eaterofnames/openoffroad/README.md

# openoffroad

A collection of offroad related part designs.

## Included parts:

* Rivian
    * R1T
        * Apex Designs Compact Reel System mount
        * Garmin PowerSwitch mount
