eaterofnames/openoffroad/rivian/common/garmin-powerswitch-mount/GarminPowerswitchLightBracket.dxf

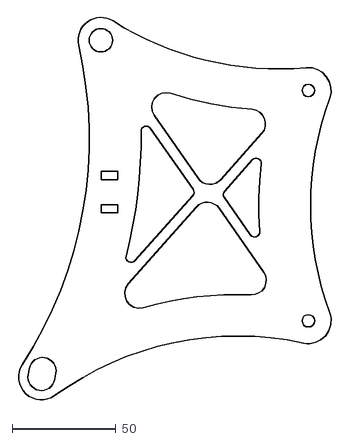
[picture p3: CAD file, 2024-07-14]
rivian/common/garmin-powerswitch-mount/GarminPowerswitchLightBracket.dxf
152.6 x 186.2
