eaterofnames/openoffroad/rivian/r1t/apex-air-reel-mount/FlatPatternOfAirReelBracket.dxf

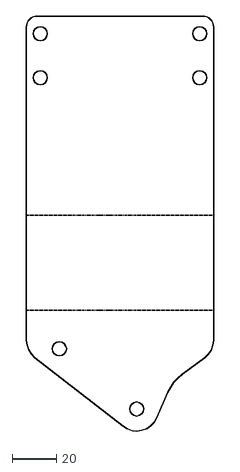
[picture p4: CAD file, 2024-07-14]
rivian/r1t/apex-air-reel-mount/FlatPatternOfAirReelBracket.dxf
85.0 x 189.0
