eaterofnames/openoffroad/rivian/r1t/apex-air-reel-mount/AirReelBracket.step

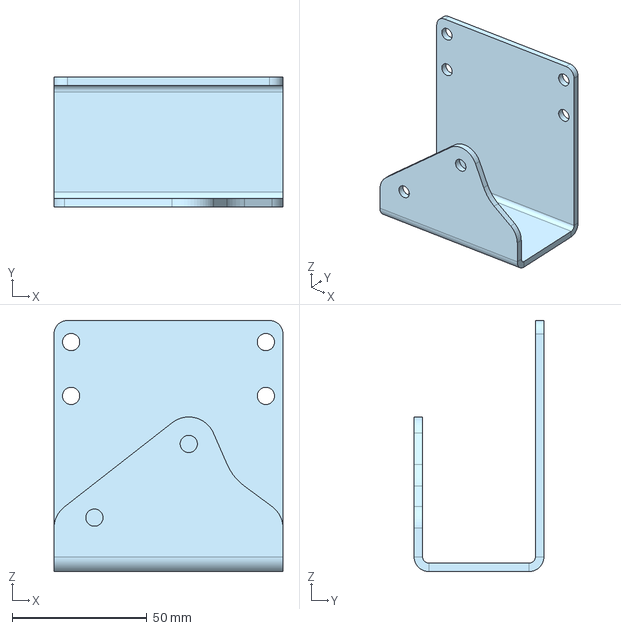
[picture p5: CAD file, 2024-07-14]
rivian/r1t/apex-air-reel-mount/AirReelBracket.step
85.0 x 48.2 x 93.2 mm
