eaterofnames/openoffroad/rivian/r1t/apex-air-reel-mount/GearGuardInsert.step

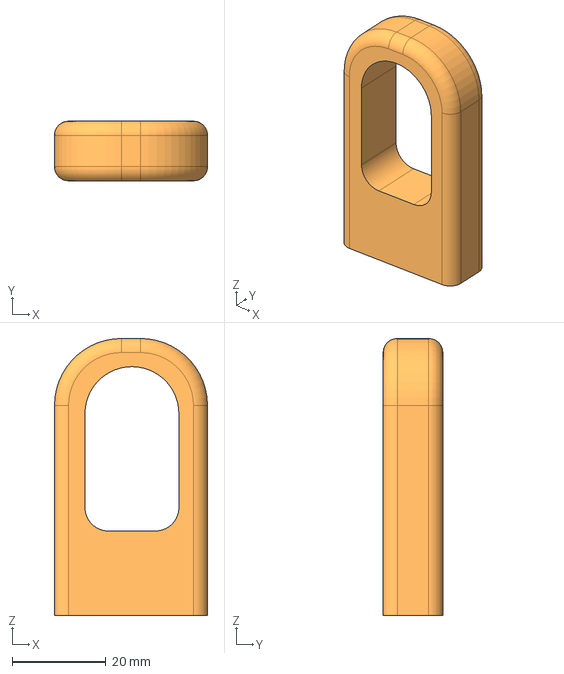
[picture p6: CAD file, 2024-07-14]
rivian/r1t/apex-air-reel-mount/GearGuardInsert.step
32.6 x 12.7 x 59.0 mm
