eaterofnames/openoffroad/rivian/r1t/apex-air-reel-mount/GearGuardInsertDrawing.pdf

2
1

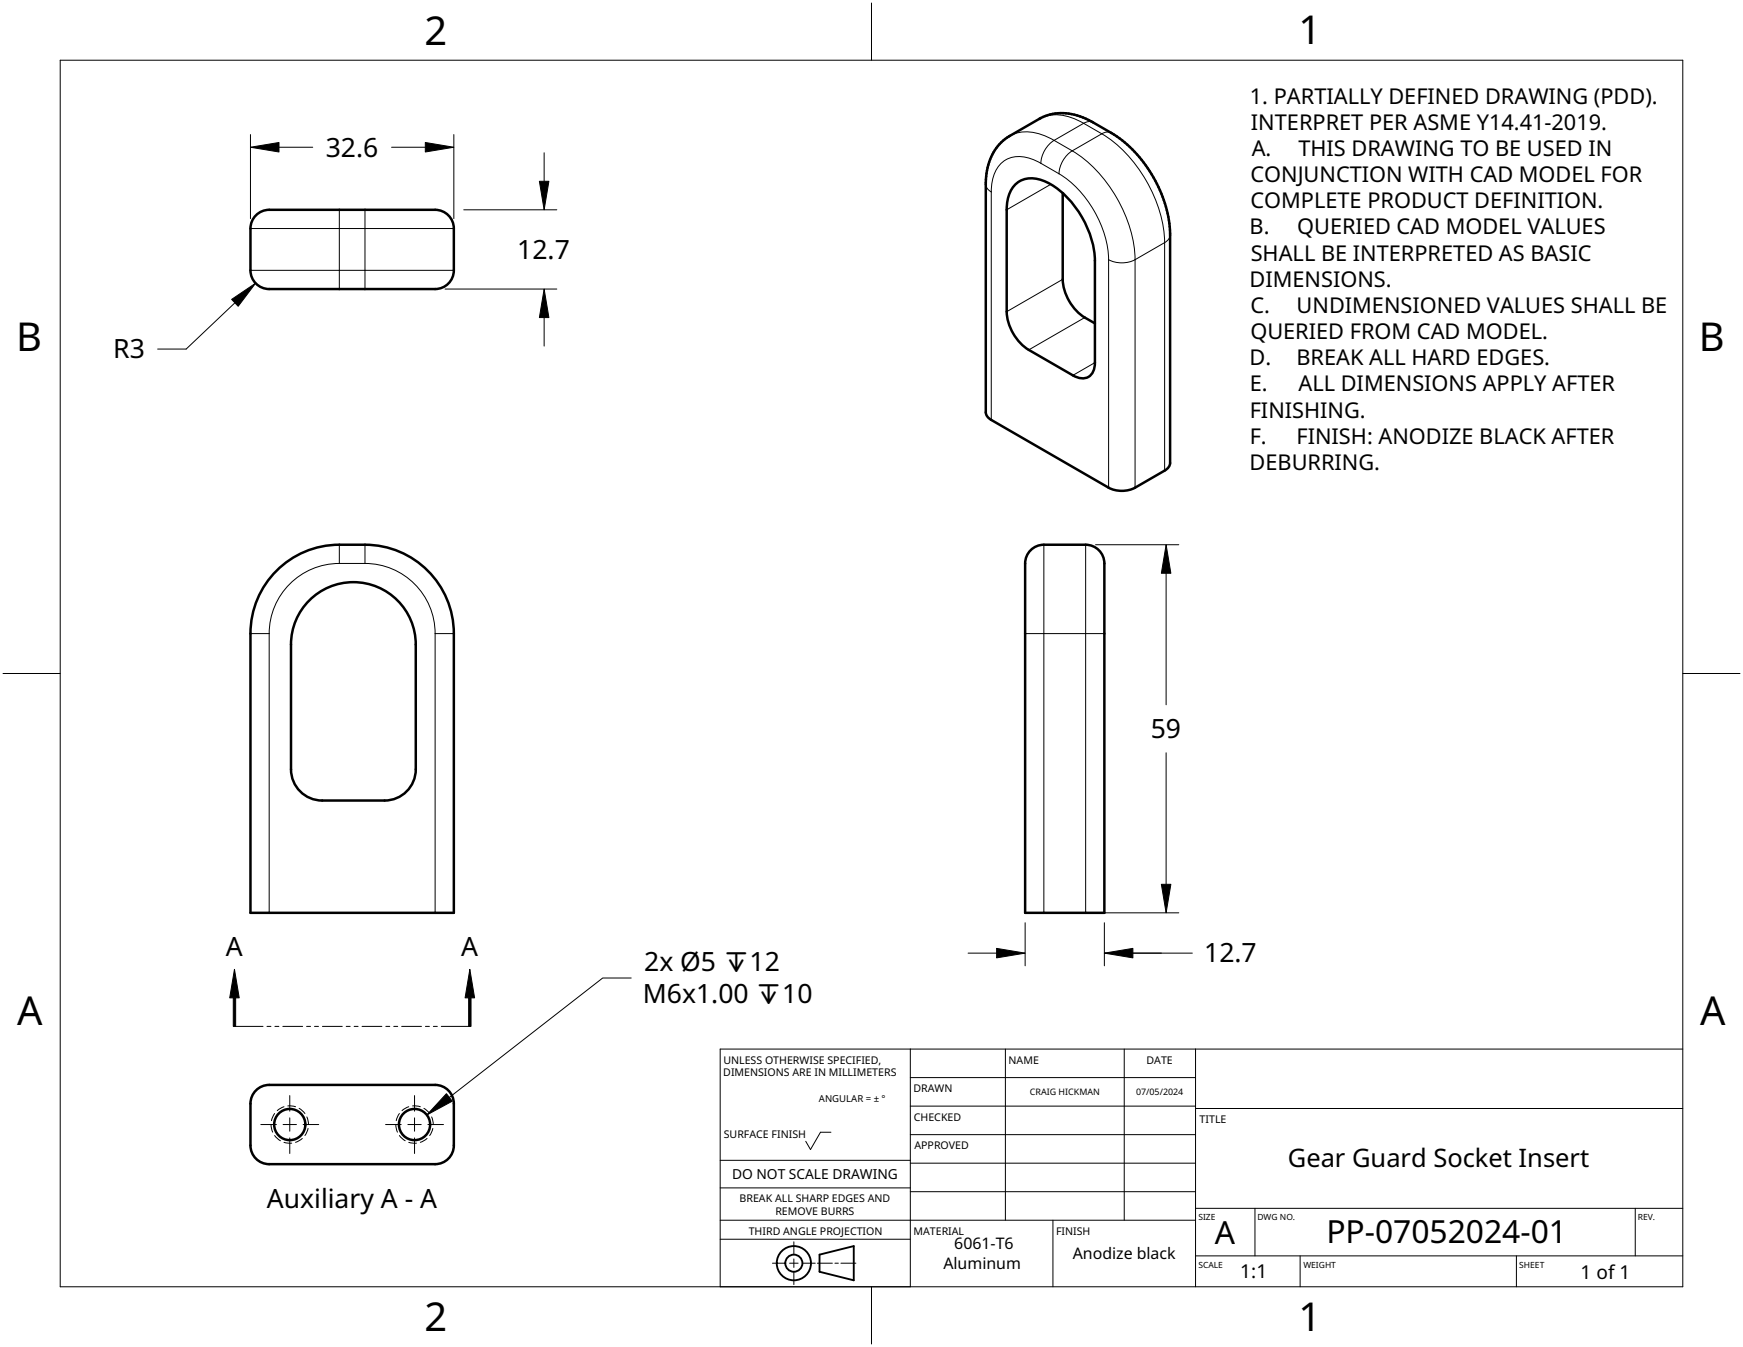
[picture p7: page 1]
MATERIAL 6061-T6 Aluminum; FINISH Anodize black; Auxiliary A - A

1. PARTIALLY DEFINED DRAWING (PDD).
INTERPRET PER ASME Y14.41-2019.
A. THIS DRAWING TO BE USED IN
CONJUNCTION WITH CAD MODEL FOR
COMPLETE PRODUCT DEFINITION.
B. QUERIED CAD MODEL VALUES
SHALL BE INTERPRETED AS BASIC
DIMENSIONS.
C. UNDIMENSIONED VALUES SHALL BE
QUERIED FROM CAD MODEL.
D. BREAK ALL HARD EDGES.
E. ALL DIMENSIONS APPLY AFTER
FINISHING.
F. FINISH: ANODIZE BLACK AFTER
DEBURRING.

UNLESS OTHERWISE SPECIFIED, DIMENSIONS ARE IN MILLIMETERS ANGULAR = ± ° SURFACE FINISH | | NAME | DATE

DRAWN | CRAIG HICKMAN | 07/05/2024

CHECKED | | | TITLE Gear Guard Socket Insert

APPROVED

DO NOT SCALE DRAWING

BREAK ALL SHARP EDGES AND

REMOVE BURRS
THIRD ANGLE PROJECTION

SIZE A | DWG NO. PP-07052024-01 | REV.

SCALE 1:1 | WEIGHT | SHEET 1 of 1
