eaterofnames/openoffroad/(commit log)

2024-07-14 Add Apex Designs CRS gear guard mount to OpenOffRoad repo
    [AirReelBracket.step, FlatPatternOfAirReelBracket.dxf, GearGuardInsert.step]
2024-07-14 Add Garmin PowerSwitch mounting bracket
    [GarminPowerswitchLightBracket.dxf]
